JyeSmith/18650-Backpack/img/digispark_attiny85.jpg

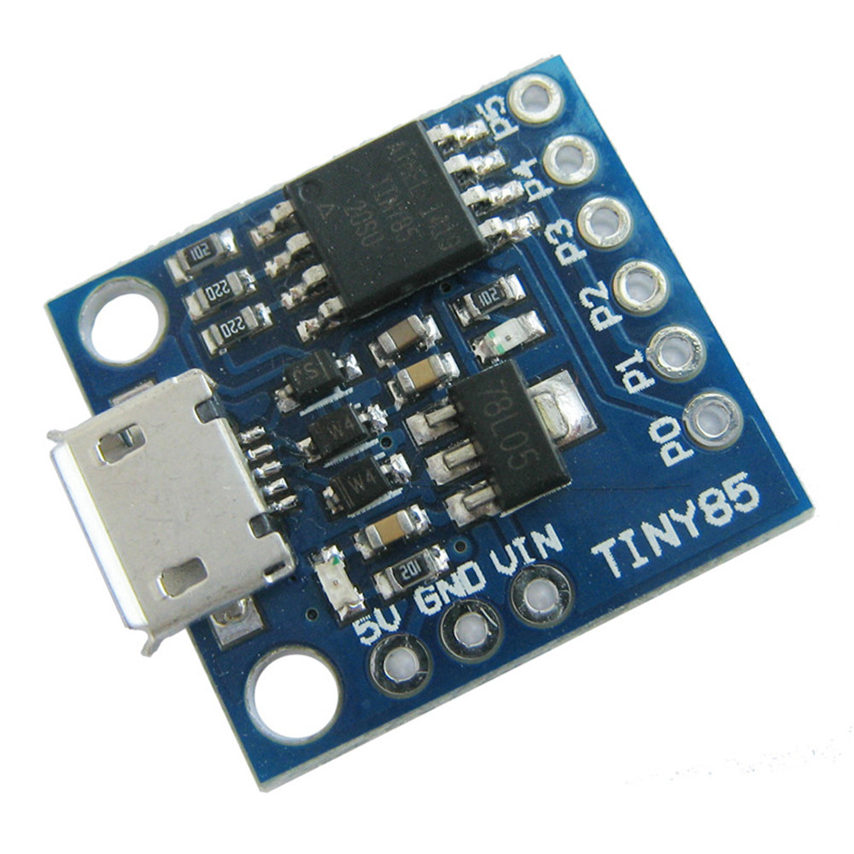
img/digispark_attiny85.jpg
