JyeSmith/18650-Backpack/img/ina219.jpg

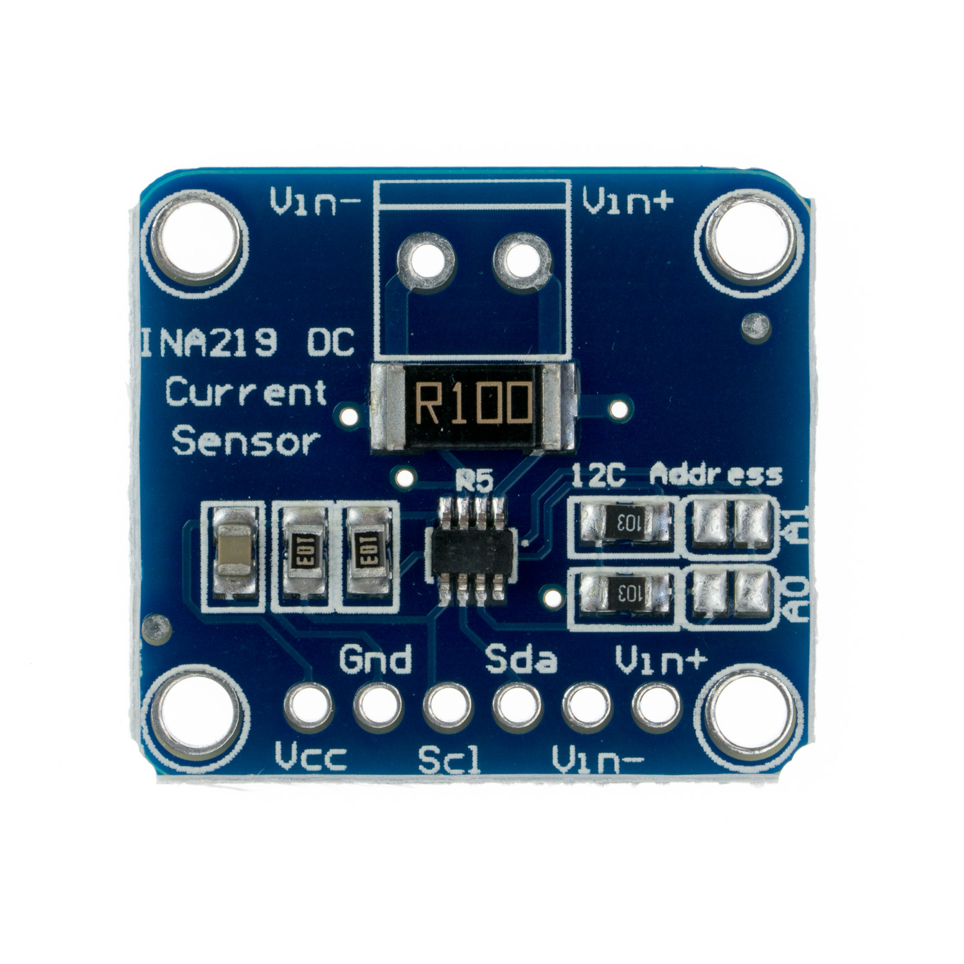
img/ina219.jpg
