JyeSmith/18650-Backpack/pcb/18650-Backpack-Render.png

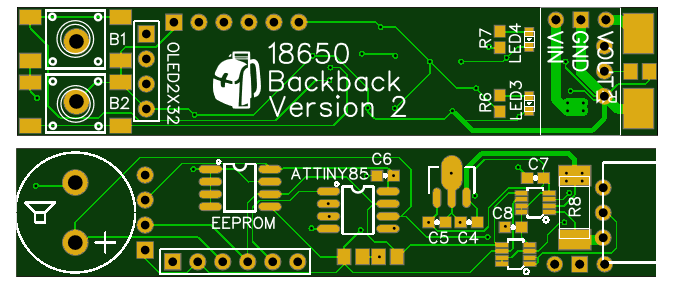
pcb/18650-Backpack-Render.png
