JyeSmith/18650-Backpack/pcb/18650-Backpack-Schematic-V2-EEPROM.png

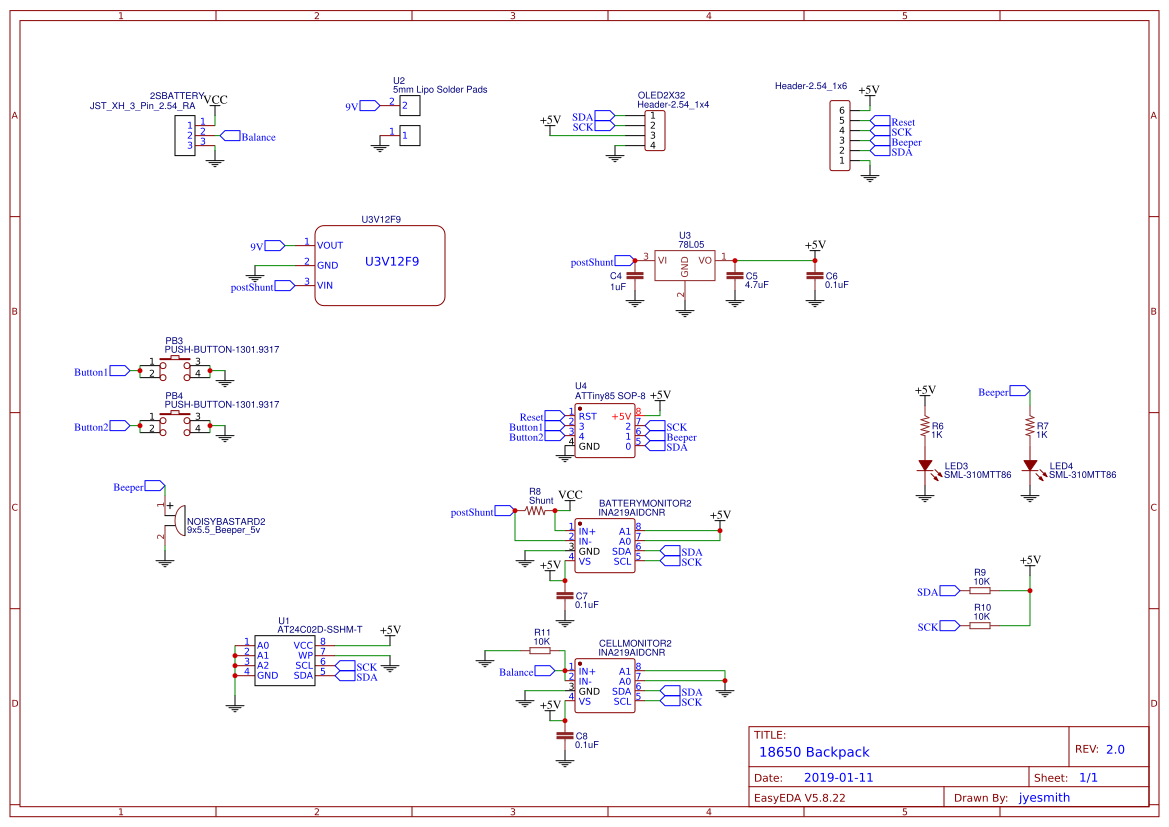
pcb/18650-Backpack-Schematic-V2-EEPROM.png
