JyeSmith/18650-Backpack/(threads)

Thread 1 (2019-02-10):

5 second EEPROM writes will cause write exhaustion in under 200 hours

mon, 2019-02-10:
Logic: 100k writes / writes per hour
Writes per hour = (60/5)*60

Either slow the rate, or do some load balancing (change EEPROM address every 100k writes?) since it's 100k per cell, not for the entire flash.

JyeSmith, 2019-02-10:
Youre not wrong!  Ive added an external eeprom (at24c02) to the pcb but Im yet to test is there is enough memory for the exteeprom lib.  Things to do...

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

mon, 2019-02-10:
Great to hear it! Sounds like it'll (probably) be sorted then :)

JyeSmith, 2019-02-10:
Thanks for having a good enough look to pick that up!

If you see anywhere code can be optimised for space let me know, or submit a pull.  My next step is to cut back the font sone more.

mon, 2019-02-10:
The 2 major things are gonna be the Arduino backend and the font. Might be more trouble than it's worth.

JyeSmith, 2019-02-13:
External eeprom added :)

https://github.com/JyeSmith/18650-Backpack/commit/c09f394be49028447418069dc1ab59f5c57f5c23

Closed 2019-02-13.

Thread 2 (2019-06-13):

smart cable for Fartshark

jonathan2018, 2019-06-13:
this is project can modifi to  smart cable for Fartshark ?
Feature  :
ON/OFF  power
display volt ampe when Fs work
alarm batterry ,auto Off when not use a long time
thanks

JyeSmith, 2019-06-13:
You sure can.  Just stick it on a cable with an inline power switch.

But at the moment it only takes a 2s battery.  This is due to the step up 9v regulator powering the goggles.  If this was replace with a S10V3F9 then you could use up to 4s, but I have not tested this.

Pololu 9V Step-Up/Step-Down Voltage Regulator S10V3F9
https://www.pololu.com/product/2095

jonathan2018, 2019-06-13:
Thanks for answer
I rebuild diagram for project . However , attiny85 with 4k memory maybe no problem ?

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

JyeSmith, 2019-06-13:
Yep the flash is pretty much full at the moment.  You'll need to use a non software on off button.

jonathan2018, 2019-06-13:
i m reading source code to understand and modifi from your code . maybe lost times for me to do it work

JyeSmith, 2019-06-13:
Any reason you need a software power button?

jonathan2018, 2019-06-13:
reason : i want to ON/OFF power for FS  instead plug in or remove Jack .Fs have not Switch power .
Display infor volt ,ampe ...on LCD  is advantage and combined  feature sofware power is so good.

Orginal your project have all infor on LCD OLED  .

skaman82, 2019-06-14:
Great project: made something similar https://github.com/skaman82/PowerPuck :)

JyeSmith, 2019-06-14:
@skaman82 I came across yours when I started mine... This is how I found the 9v reg to use 😉

By the way, your prints look awesome!!! I just heatshrinked mine and have it dangling from my head LOL
