JyeSmith/18650-Backpack/18650_Backpack/18650_Backpack.ino

/*
MIT License

Copyright (c) 2019 Jye Smith

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
THE SOFTWARE IS PROVIDED "AS IS", WITHOUT WARRANTY OF ANY KIND, EXPRESS OR
IMPLIED, INCLUDING BUT NOT LIMITED TO THE WARRANTIES OF MERCHANTABILITY,
FITNESS FOR A PARTICULAR PURPOSE AND NONINFRINGEMENT. IN NO EVENT SHALL THE
AUTHORS OR COPYRIGHT HOLDERS BE LIABLE FOR ANY CLAIM, DAMAGES OR OTHER
LIABILITY, WHETHER IN AN ACTION OF CONTRACT, TORT OR OTHERWISE, ARISING FROM,
OUT OF OR IN CONNECTION WITH THE SOFTWARE OR THE USE OR OTHER DEALINGS IN THE
SOFTWARE.
*/

#include <TinyWireM.h>
#include "voltage.h"
#include "display.h"
#include "beeper.h"
#include "button.h"
#include "alarms.h"
#include "time.h"
#include "timer.h"
#include "at24c02_eeprom.h"

void setup() {
  
  Buttons::setup(); // Setup buttons first so they can be read during eeprom

  EepromSettings.setup();
  EepromSettings.load();

  Time::setup();

  Voltage::setup();
  Display::setup();

  Voltage::update();
  Display::update();

  Beeper::setup();

  // Interrupt for buttons
  GIMSK = 0b00100000;    // turns on pin change interrupts
  PCMSK = 0b00011000;    // turn on interrupts on pins PB3 and PB4
  sei();

}

void loop() {

  Time::update();
  Buttons::update();
  Voltage::update();
  Alarms::update();
  Display::update();
  
}

// Button interrupt function
ISR(PCINT0_vect) {

  if (!digitalRead(buttonMode)) {
    Buttons::buttonModePressed = true;
  }
  else if (!digitalRead(buttonChange)) {
    Buttons::buttonChangePressed = true;
  }

}
