JyeSmith/18650-Backpack/18650_Backpack/settings.h

#ifndef SETTINGS_H
#define SETTINGS_H

#define eepromVersionNumber         1 // 1=0.01

#define pinBeeper                   1
#define buttonMode                  3
#define buttonChange                4

#define alarmHysteresis             20    // 20 = 0.20 volts

#define mAhUpdatePeriod             2500

#define alarmUpdatePeriod           20000
#define alarmUpdatePeriodCritical   200

#define beepDuration                100   // ms

#endif
