JyeSmith/18650-Backpack/(commit log)

2019-02-06 initial
    Breadboard prototype working and waiting for PCBs to be delivered.
2019-02-13 reduce eeprom save rate
    Only has 1 million writes cycles
2019-02-13 Update schematic with eeprom
2019-02-15 adds balance wire detection
    If Fatshark pack is used without a balance wire pseudo cell readings are used e.g. pack voltage divided by 2.
2019-02-18 improve missing balance wire detection
    [voltage.cpp]
2019-02-18 update pcb with version2
2019-02-19 adds BOM to readme
